jamieparkinson/nixie/hardware/nixie.pdf

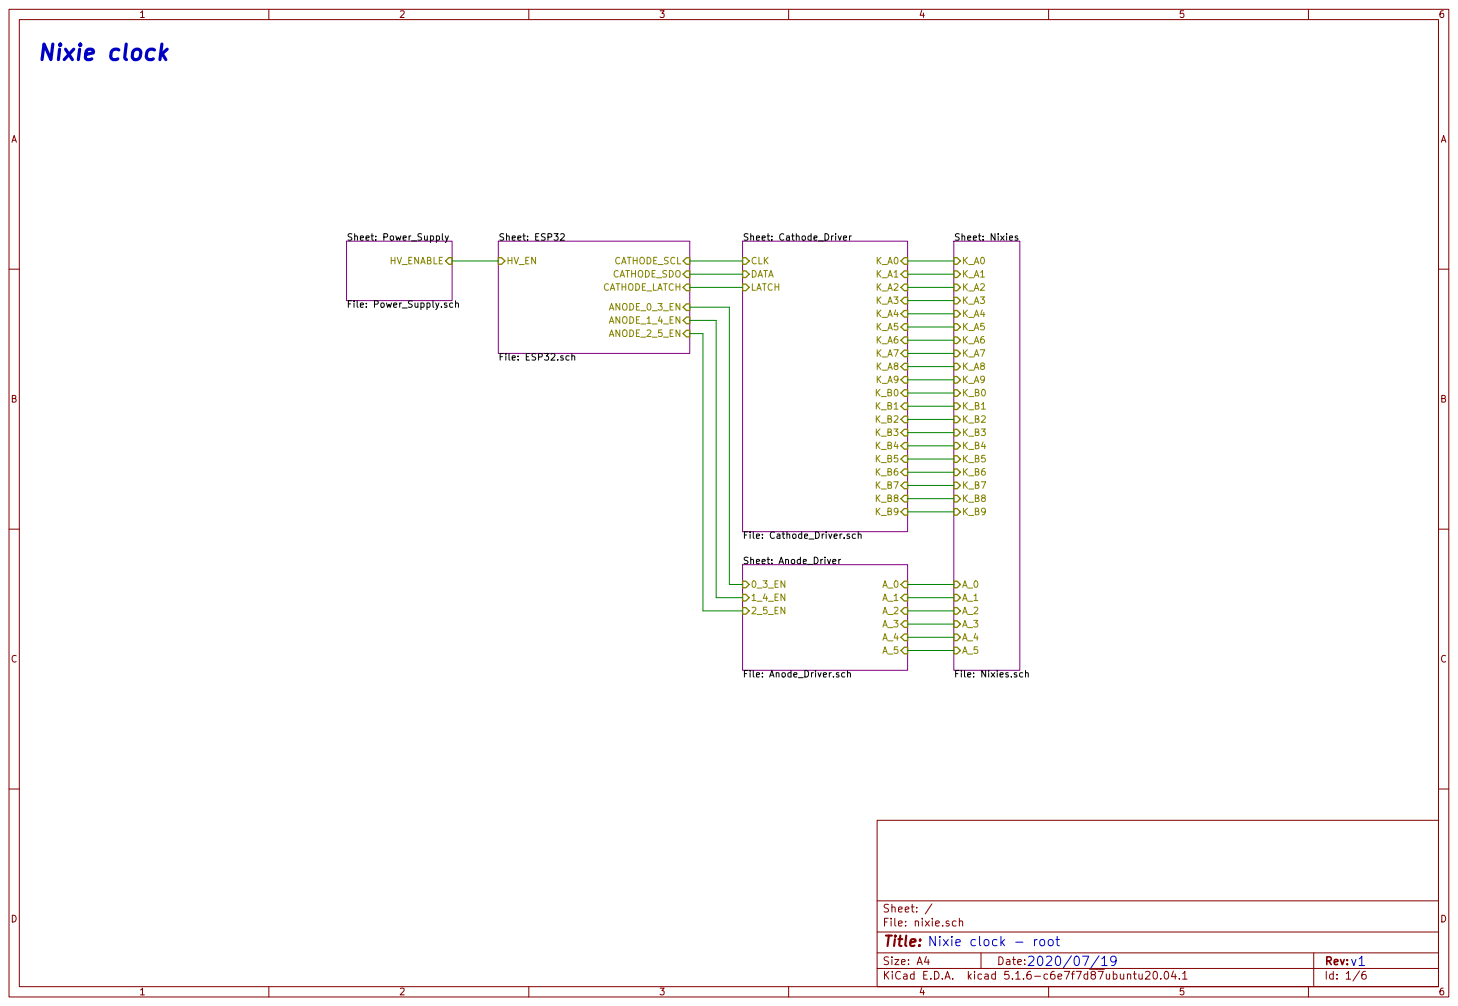
[picture p1: page 1]

Sheet: Nixies File: Nixies.sch A_0 A_1 A_2 A_3 A_4 A_5 K_B0 K_B1 K_B2 K_B3 K_B4 K_B5 K_B6 K_B7 K_B8 K_B9 K_A0 K_A1 K_A2 K_A3 K_A4 K_A5 K_A6 K_A7 K_A8 K_A9 Nixie clock - root

Id: 1/6 Title: File: nixie.sch Sheet: /

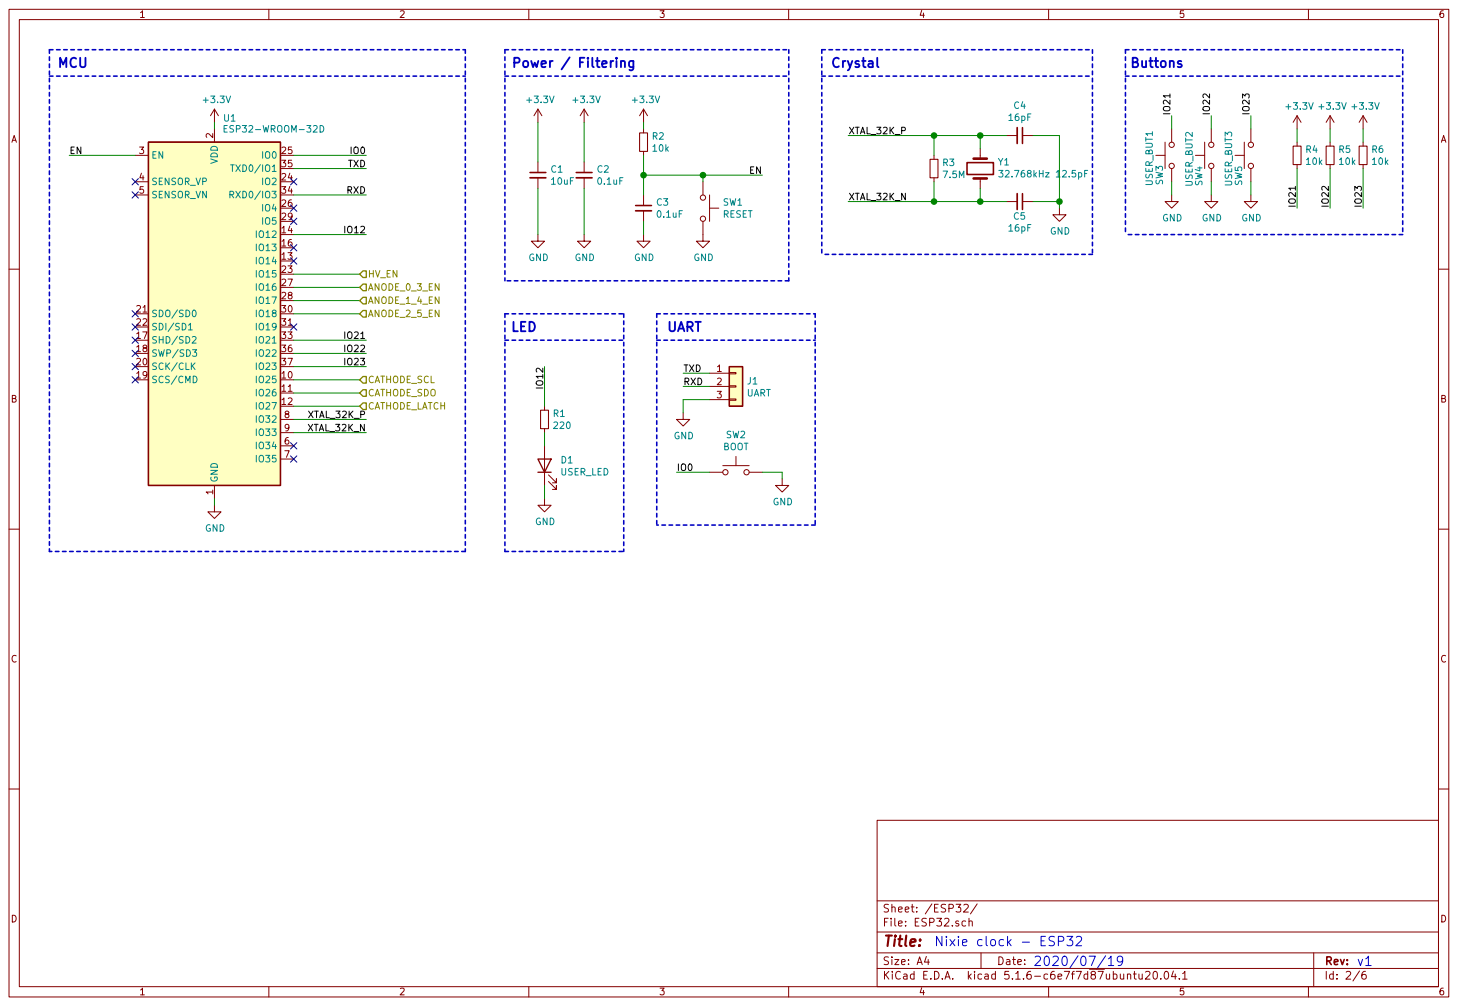
[picture p2: page 2]

2 SCK/CLK 20 SDO/SD0 21 SDI/SD1 22

Id: 2/6 Title: File: ESP32.sch Sheet: /ESP32/

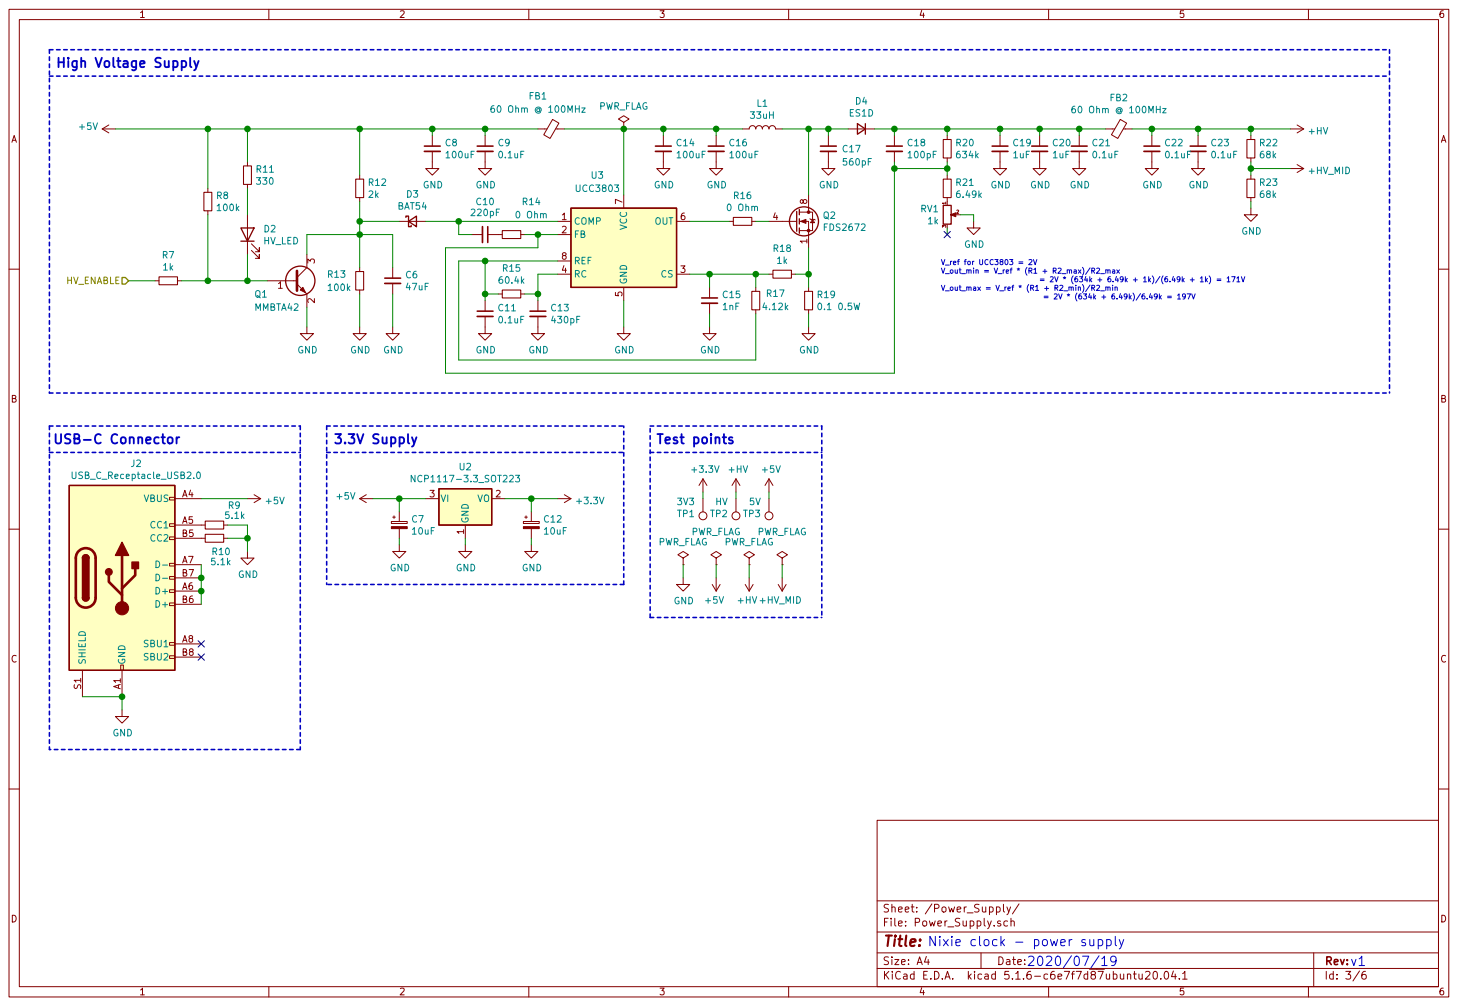
[picture p3: page 3]

File: Power_Supply.sch
Id: 3/6 Title:
Nixie clock - power supply

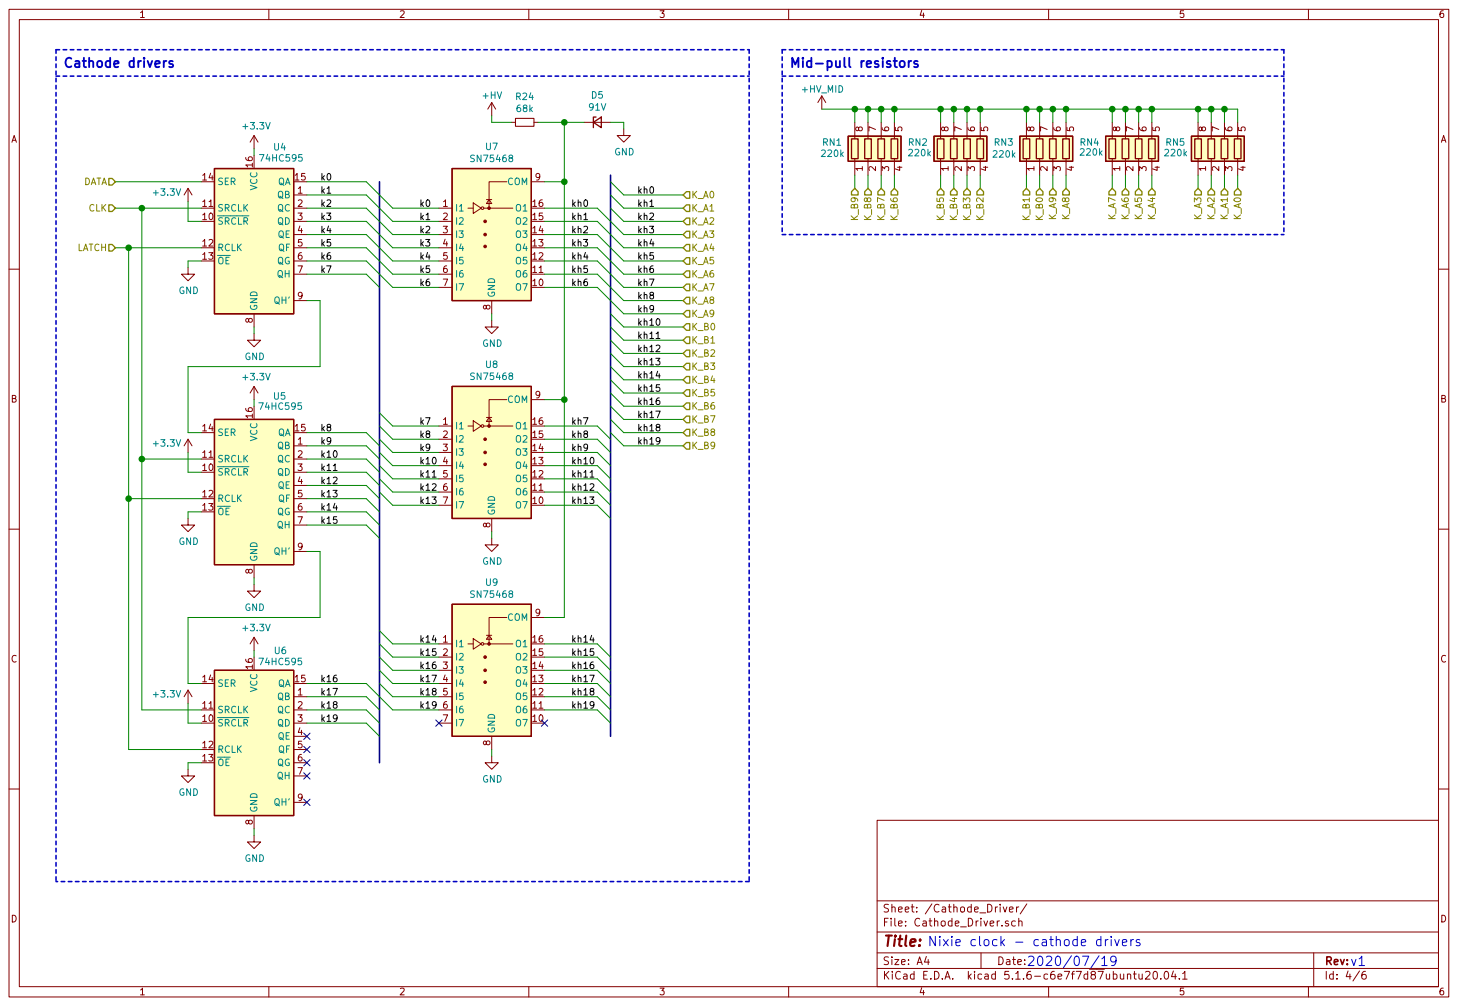
[picture p4: page 4]

Sheet: /Cathode_Driver/
File: Cathode_Driver.sch
Id: 4/6 Title:
Nixie clock - cathode drivers

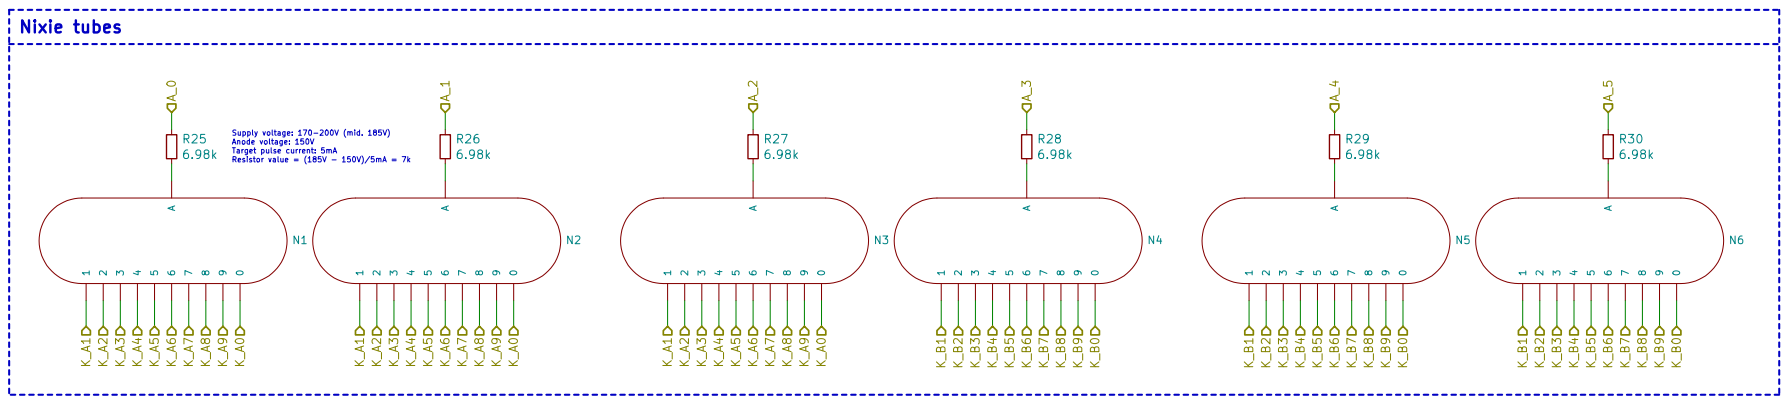
[picture p5: page 5]

Supply voltage: 170-200V (mid. 185V) Anode voltage: 150V

Target pulse current: 5mA Resistor value = (185V - 150V)/5mA = 7k

Id: 5/6 Title: File: Nixies.sch Sheet: /Nixies/
Nixie clock - nixie tubes

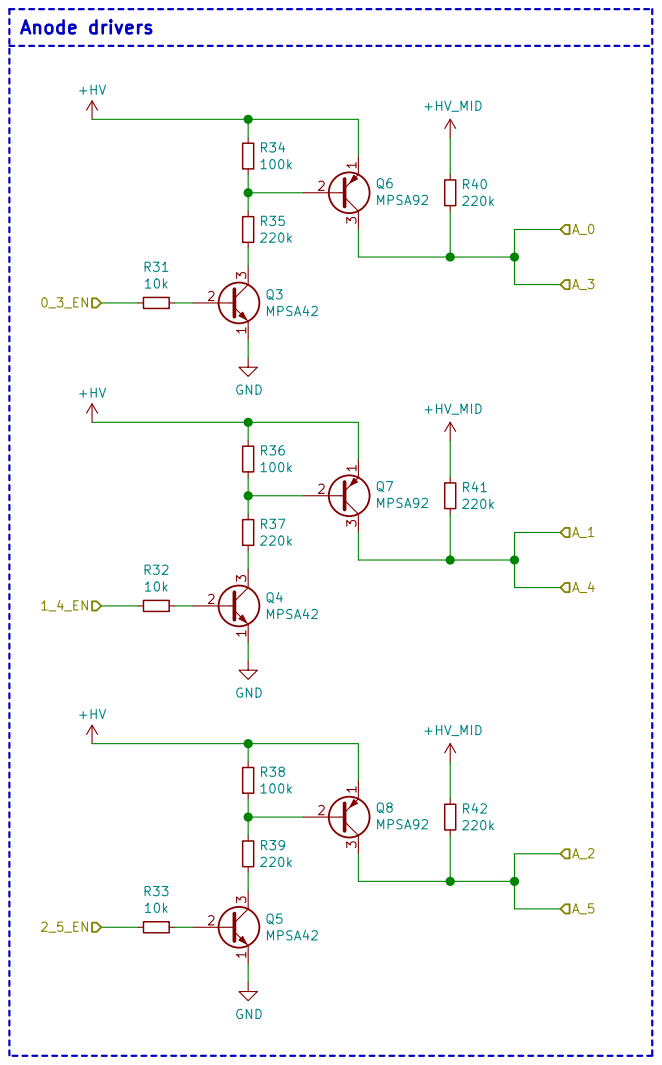
[picture p6: page 6]

File: Anode_Driver.sch
Id: 6/6 Title:
Nixie clock - anode driver
