jamieparkinson/nixie/hardware/nixie.kicad_pcb

## KiCad design hardware/nixie.kicad_pcb (2020-08-09)

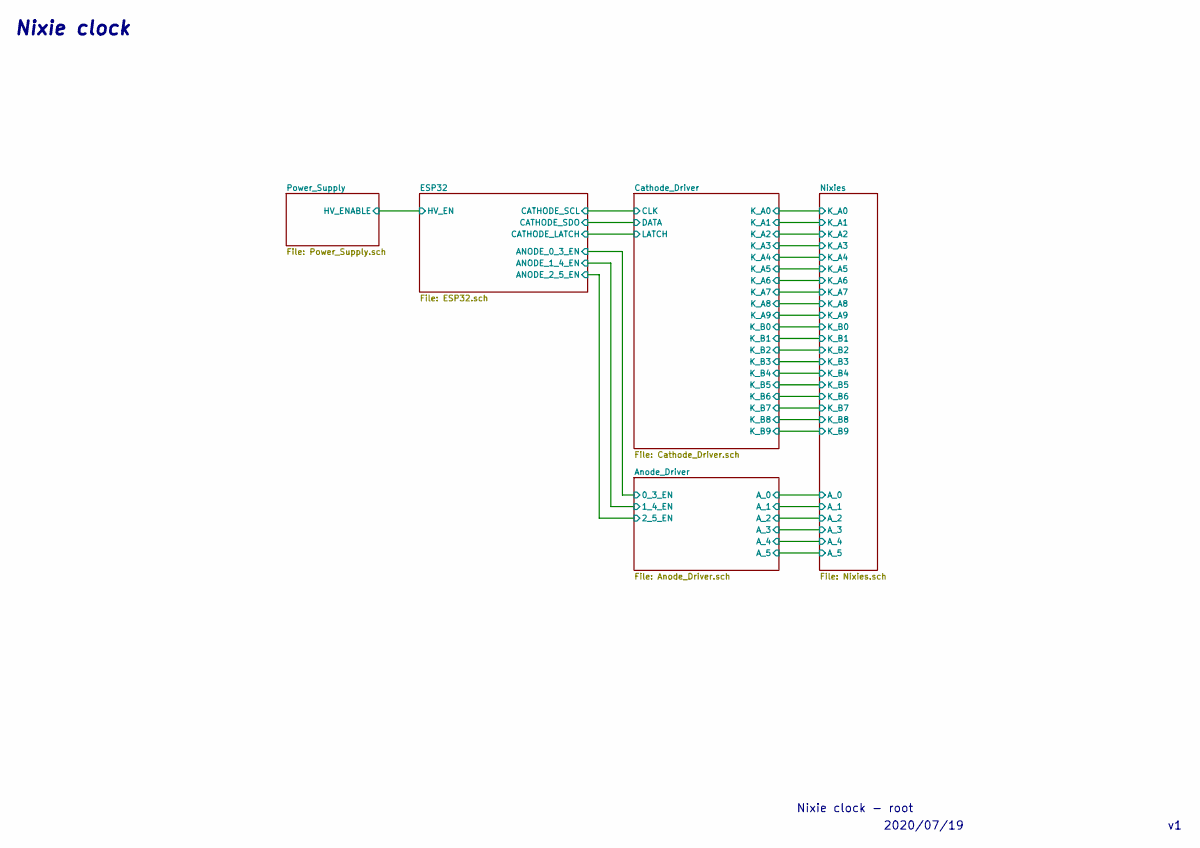
[picture p7: schematic nixie.sch]

Notes on the sheet:
Nixie clock - root
2020/07/19
Nixie clock

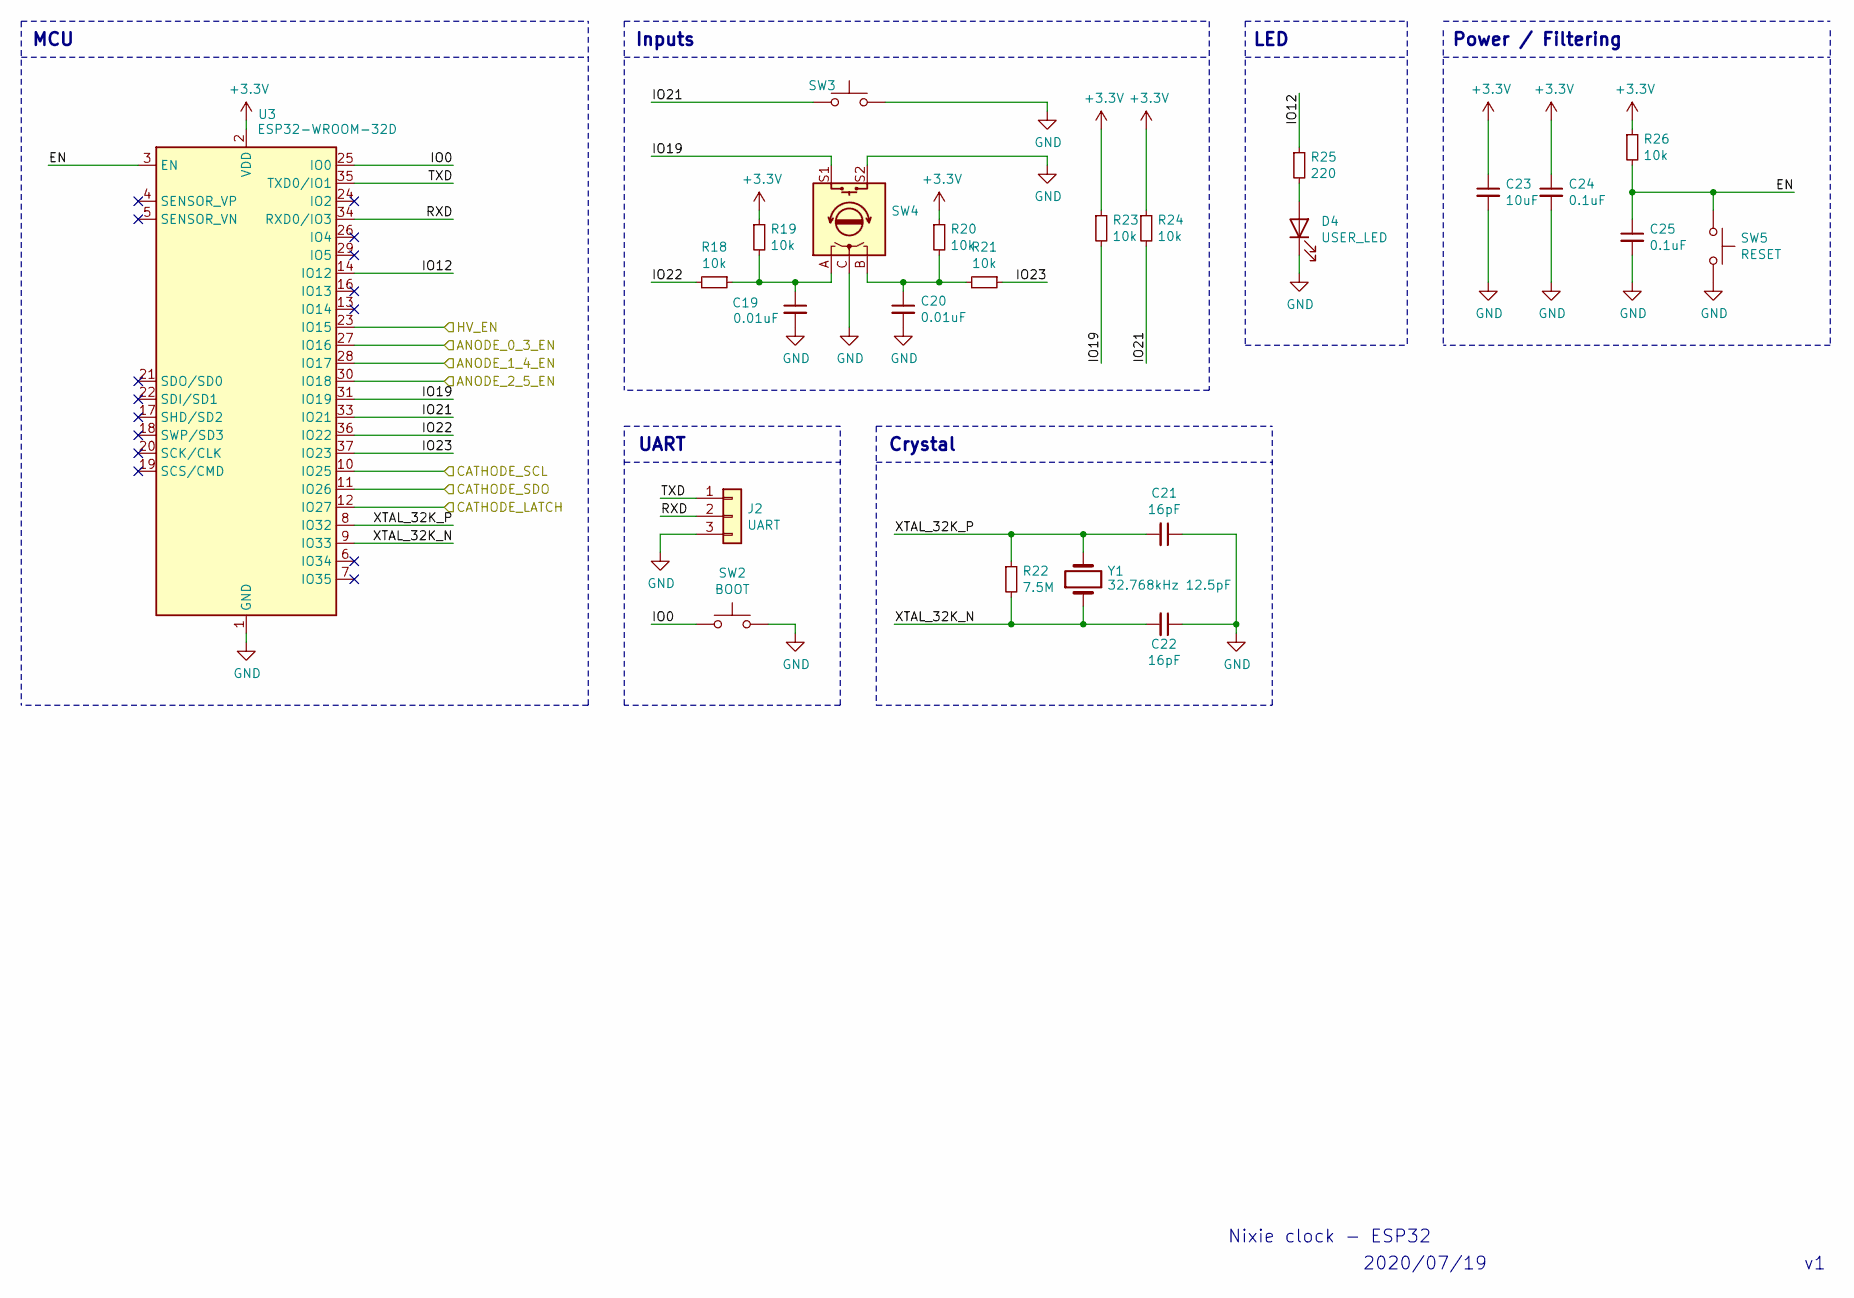
[picture p8: schematic ESP32.sch]

Parts:
C19, C20: 0.01uF; C_0603_1608Metric
C21, C22: 16pF; C_0603_1608Metric
C23: 10uF; C_0603_1608Metric
C24, C25: 0.1uF; C_0603_1608Metric
D4: USER_LED; LED_0805_2012Metric
J2: UART; PinHeader_1x03_P2.54mm_Horizontal
R18, R19, R20, R21, R23, R24, R26: 10k; R_0603_1608Metric
R22: 7.5M; R_0603_1608Metric
R25: 220; R_0603_1608Metric
SW2: BOOT; SW_Push_1P1T-SH_NO_CK_KMR2xxG
SW3: USER_BUT1; Switch_CK_D6
SW4: Rotary Encoder; RotaryEncoder_Alps_EC12E-Switch_Vertical_H20mm
SW5: RESET; SW_Push_1P1T-SH_NO_CK_KMR2xxG
U3: ESP32-WROOM-32D; ESP32-WROOM-32
Y1: 32.768kHz 12.5pF; XTAL_LFXTAL003000

Connections:
+3V3: C23.1, C24.1, R19.1, R20.1, R23.1, R24.1, R26.1, U3.2 (VDD); also elsewhere on the board
/Anode_Driver/0_3_EN: U3.27 (IO16); also elsewhere on the board
/Anode_Driver/1_4_EN: U3.28 (IO17); also elsewhere on the board
/Anode_Driver/2_5_EN: U3.30 (IO18); also elsewhere on the board
/ESP32/CATHODE_LATCH: U3.12 (IO27); also elsewhere on the board
/ESP32/CATHODE_SCL: U3.10 (IO25); also elsewhere on the board
/ESP32/CATHODE_SDO: U3.11 (IO26); also elsewhere on the board
/ESP32/EN: C25.1, R26.2, SW5.1, U3.3 (EN)
/ESP32/HV_EN: U3.23 (IO15); also elsewhere on the board
/ESP32/IO0: SW2.1, U3.25 (IO0)
/ESP32/IO12: R25.1, U3.14 (IO12)
/ESP32/IO19: R23.2, SW4.S1, U3.31 (IO19)
/ESP32/IO21: R24.2, SW3.1, U3.33 (IO21)
/ESP32/IO22: R18.2, U3.36 (IO22)
/ESP32/IO23: R21.1, U3.37 (IO23)
/ESP32/RXD: J2.2, U3.34 (RXD0/IO3)
/ESP32/TXD: J2.1, U3.35 (TXD0/IO1)
/ESP32/XTAL_32K_N: C22.2, R22.2, U3.9 (IO33), Y1.1
/ESP32/XTAL_32K_P: C21.2, R22.1, U3.8 (IO32), Y1.2
GND: C19.2, C20.2, C21.1, C22.1, C23.2, C24.2, C25.2, D4.1 (K), J2.3, SW2.2, SW3.2, SW4.C, SW4.S2, SW5.2, U3.1 (GND), U3.15 (GND), U3.38 (GND), U3.39 (GND); also elsewhere on the board
unnamed: C19.1, R18.1, R19.2, SW4.A
unnamed: C20.1, R20.2, R21.2, SW4.B
unnamed: D4.2 (A), R25.2

Notes on the sheet:
MCU
Power / Filtering
Crystal
LED
UART
Nixie clock - ESP32
2020/07/19
Inputs

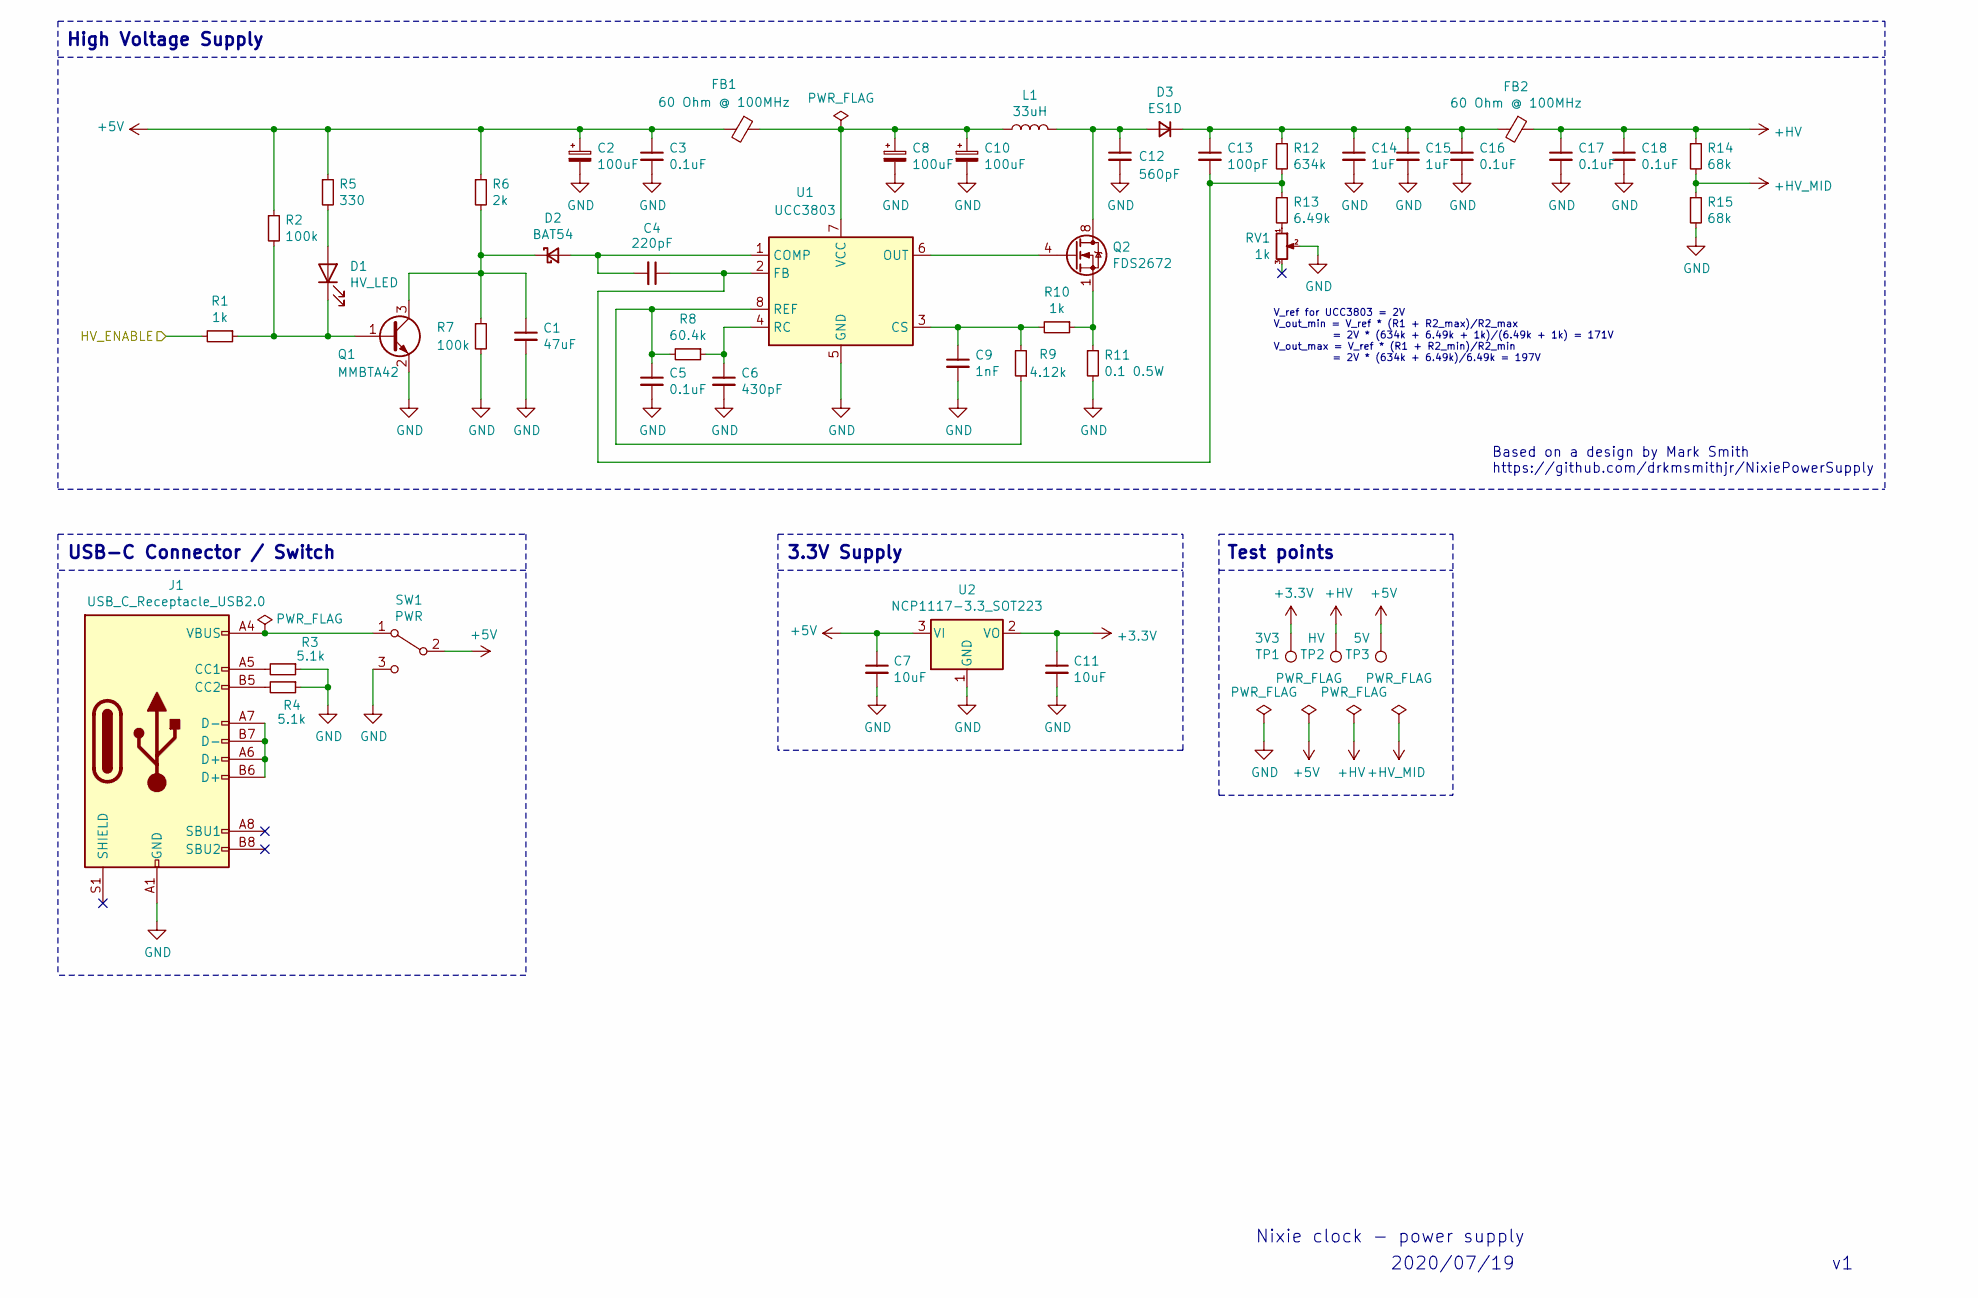
[picture p9: schematic Power_Supply.sch]

Parts:
C1: 47uF; C_0603_1608Metric
C2, C8, C10: 100uF; CP_Elec_5x5.4
C3, C5, C16, C17, C18: 0.1uF; C_0603_1608Metric
C4: 220pF; C_0603_1608Metric
C6: 430pF; C_0603_1608Metric
C7, C11: 10uF; C_0603_1608Metric
C9: 1nF; C_0603_1608Metric
C12: 560pF; C_0603_1608Metric
C13: 100pF; C_0603_1608Metric
C14, C15: 1uF; C_0603_1608Metric
D1: HV_LED; LED_0805_2012Metric
D2: BAT54; D_SOT-23_ANK
D3: ES1D; D_SMA_Handsoldering
FB1, FB2: 60 Ohm @ 100MHz; L_0603_1608Metric
J1: USB_C_Receptacle_USB2.0; WURTH_632723100011
L1: 33uH; L_12x12mm_H8mm
Q1: MMBTA42; SOT-23
Q2: FDS2672; SOIC-8_3.9x4.9mm_P1.27mm
R1, R10: 1k; R_0603_1608Metric
R2, R7: 100k; R_0603_1608Metric
R3, R4: 5.1k; R_0603_1608Metric
R5: 330; R_0603_1608Metric
R6: 2k; R_0603_1608Metric
R8: 60.4k; R_0603_1608Metric
R9: 4.12k; R_0603_1608Metric
R11: 0.1 0.5W; R_1210_3225Metric
R12: 634k; R_0603_1608Metric
R13: 6.49k; R_0603_1608Metric
R14, R15: 68k; R_0603_1608Metric
RV1: 1k; Potentiometer_Bourns_3314G_Vertical
SW1: PWR; SW_SPDT_CK-JS102011SAQN
TP1: 3V3; TestPoint_Pad_D2.0mm
TP2: HV; TestPoint_Pad_D2.0mm
TP3: 5V; TestPoint_Pad_D2.0mm
U1: UCC3803; SOIC-8_3.9x4.9mm_P1.27mm
U2: NCP1117-3.3_SOT223; SOT-223-3_TabPin2

Connections:
+3V3: C11.1, TP1.1, U2.2 (VO); also elsewhere on the board
+5V: C2.1, C3.1, C7.1, FB1.2, R2.1, R5.1, R6.1, SW1.2 (B), TP3.1, U2.3 (VI)
+HV: C17.1, C18.1, FB2.1, R14.1, TP2.1; also elsewhere on the board
+HV_MID: R14.2, R15.1; also elsewhere on the board
/ESP32/HV_EN: R1.2; also elsewhere on the board
GND: C1.2, C2.2, C3.2, C5.2, C6.2, C7.2, C8.2, C9.2, C10.2, C11.2, C12.2, C14.2, C15.2, C16.2, C17.2, C18.2, J1.A1 (GND), J1.A12 (GND), J1.B1 (GND), J1.B12 (GND), Q1.2 (E), R3.1, R4.1, R7.2, R11.2, R15.2, RV1.2, SW1.3 (C), U1.5 (GND), U2.1 (GND); also elsewhere on the board
unnamed: C1.1, D2.1 (K), Q1.3 (C), R6.2, R7.1
unnamed: C4.2, D2.2 (A), U1.1 (COMP)
unnamed: C5.1, R8.2, R9.1, U1.8 (REF)
unnamed: C6.1, R8.1, U1.4 (RC)
unnamed: C9.1, R9.2, R10.2, U1.3 (CS)
unnamed: C8.1, C10.1, FB1.1, L1.1, U1.7 (VCC)
unnamed: C12.1, D3.2 (A), L1.2, Q2.5 (D), Q2.6 (D), Q2.7 (D), Q2.8 (D)
unnamed: C13.1, C14.1, C15.1, C16.1, D3.1 (K), FB2.2, R12.1
unnamed: C4.1, C13.2, R12.2, R13.1, U1.2 (FB)
unnamed: D1.1 (K), Q1.1 (B), R1.1, R2.2
unnamed: D1.2 (A), R5.2
unnamed: J1.A4 (VBUS), J1.A9 (VBUS), J1.B4 (VBUS), J1.B9 (VBUS), SW1.1 (A)
unnamed: J1.A5 (CC1), R3.2
unnamed: J1.A6 (D+), J1.A7 (D-), J1.B6 (D+), J1.B7 (D-)
unnamed: J1.B5 (CC2), R4.2
unnamed: Q2.1 (S), Q2.2 (S), Q2.3 (S), R10.1, R11.1
unnamed: Q2.4 (G), U1.6 (OUT)
unnamed: R13.2, RV1.1

Notes on the sheet:
USB-C Connector / Switch
3.3V Supply
Test points
High Voltage Supply
Nixie clock - power supply
2020/07/19
V_ref for UCC3803 = 2V V_out_min = V_ref * (R1 + R2_max)/R2_max = 2V * (634k + 6.49k + 1k)/(6.49k + 1k) = 171V V_out_max = V_ref * (R1 + R2_min)/R2_min = 2V * (634k + 6.49k)/6.49k = 197V
Based on a design by Mark Smith https://github.com/drkmsmithjr/NixiePowerSupply

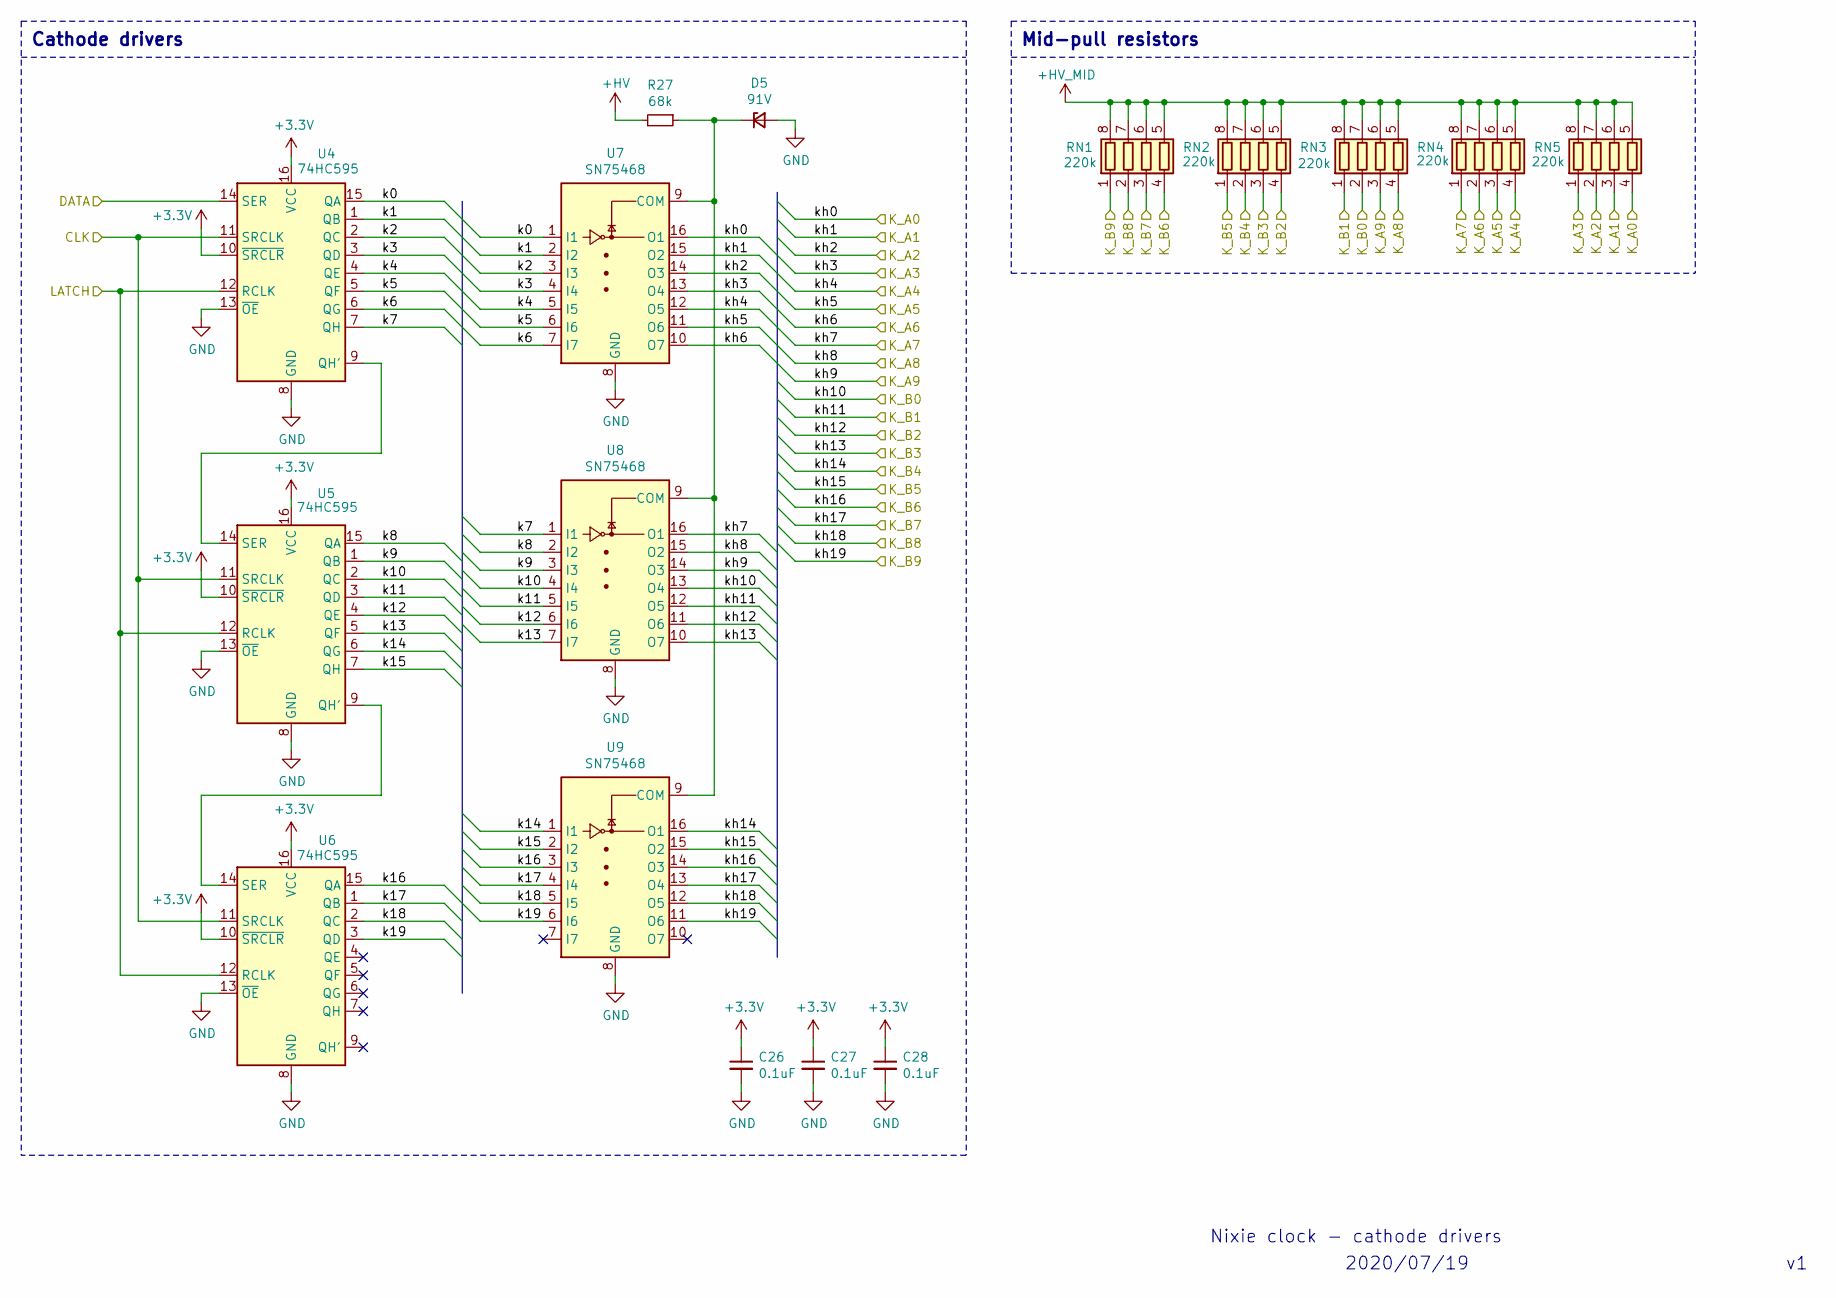
[picture p10: schematic Cathode_Driver.sch]

Parts:
C26, C27, C28: 0.1uF; C_0603_1608Metric
D5: 91V; D_SOD-123
R27: 68k; R_0603_1608Metric
RN1, RN2, RN3, RN4, RN5: 220k; R_Array_Convex_4x1206
U4, U5, U6: 74HC595; SOIC-16_3.9x9.9mm_P1.27mm
U7, U8, U9: SN75468; SOIC-16_3.9x9.9mm_P1.27mm

Connections:
+3V3: C26.1, C27.1, C28.1, U4.10 (~SRCLR), U4.16 (VCC), U5.10 (~SRCLR), U5.16 (VCC), U6.10 (~SRCLR), U6.16 (VCC); also elsewhere on the board
+HV: R27.2; also elsewhere on the board
+HV_MID: RN1.5 (R4.2), RN1.6 (R3.2), RN1.7 (R2.2), RN1.8 (R1.2), RN2.5 (R4.2), RN2.6 (R3.2), RN2.7 (R2.2), RN2.8 (R1.2), RN3.5 (R4.2), RN3.6 (R3.2), RN3.7 (R2.2), RN3.8 (R1.2), RN4.5 (R4.2), RN4.6 (R3.2), RN4.7 (R2.2), RN4.8 (R1.2), RN5.5 (R4.2), RN5.6 (R3.2), RN5.7 (R2.2), RN5.8 (R1.2); also elsewhere on the board
/Cathode_Driver/K_A0: RN5.4 (R4.1), U7.16 (O1); also elsewhere on the board
/Cathode_Driver/K_A1: RN5.3 (R3.1), U7.15 (O2); also elsewhere on the board
/Cathode_Driver/K_A2: RN5.2 (R2.1), U7.14 (O3); also elsewhere on the board
/Cathode_Driver/K_A3: RN5.1 (R1.1), U7.13 (O4); also elsewhere on the board
/Cathode_Driver/K_A4: RN4.4 (R4.1), U7.12 (O5); also elsewhere on the board
/Cathode_Driver/K_A5: RN4.3 (R3.1), U7.11 (O6); also elsewhere on the board
/Cathode_Driver/K_A6: RN4.2 (R2.1), U7.10 (O7); also elsewhere on the board
/Cathode_Driver/K_A7: RN4.1 (R1.1), U8.16 (O1); also elsewhere on the board
/Cathode_Driver/K_A8: RN3.4 (R4.1), U8.15 (O2); also elsewhere on the board
/Cathode_Driver/K_A9: RN3.3 (R3.1), U8.14 (O3); also elsewhere on the board
/Cathode_Driver/K_B0: RN3.2 (R2.1), U8.13 (O4); also elsewhere on the board
/Cathode_Driver/K_B1: RN3.1 (R1.1), U8.12 (O5); also elsewhere on the board
/Cathode_Driver/K_B2: RN2.4 (R4.1), U8.11 (O6); also elsewhere on the board
/Cathode_Driver/K_B3: RN2.3 (R3.1), U8.10 (O7); also elsewhere on the board
/Cathode_Driver/K_B4: RN2.2 (R2.1), U9.16 (O1); also elsewhere on the board
/Cathode_Driver/K_B5: RN2.1 (R1.1), U9.15 (O2); also elsewhere on the board
/Cathode_Driver/K_B6: RN1.4 (R4.1), U9.14 (O3); also elsewhere on the board
/Cathode_Driver/K_B7: RN1.3 (R3.1), U9.13 (O4); also elsewhere on the board
/Cathode_Driver/K_B8: RN1.2 (R2.1), U9.12 (O5); also elsewhere on the board
/Cathode_Driver/K_B9: RN1.1 (R1.1), U9.11 (O6); also elsewhere on the board
/Cathode_Driver/k0: U4.15 (QA), U7.1 (I1)
/Cathode_Driver/k1: U4.1 (QB), U7.2 (I2)
/Cathode_Driver/k2: U4.2 (QC), U7.3 (I3)
/Cathode_Driver/k3: U4.3 (QD), U7.4 (I4)
/Cathode_Driver/k4: U4.4 (QE), U7.5 (I5)
/Cathode_Driver/k5: U4.5 (QF), U7.6 (I6)
/Cathode_Driver/k6: U4.6 (QG), U7.7 (I7)
/Cathode_Driver/k7: U4.7 (QH), U8.1 (I1)
/Cathode_Driver/k8: U5.15 (QA), U8.2 (I2)
/Cathode_Driver/k9: U5.1 (QB), U8.3 (I3)
/Cathode_Driver/k10: U5.2 (QC), U8.4 (I4)
/Cathode_Driver/k11: U5.3 (QD), U8.5 (I5)
/Cathode_Driver/k12: U5.4 (QE), U8.6 (I6)
/Cathode_Driver/k13: U5.5 (QF), U8.7 (I7)
/Cathode_Driver/k14: U5.6 (QG), U9.1 (I1)
/Cathode_Driver/k15: U5.7 (QH), U9.2 (I2)
/Cathode_Driver/k16: U6.15 (QA), U9.3 (I3)
/Cathode_Driver/k17: U6.1 (QB), U9.4 (I4)
/Cathode_Driver/k18: U6.2 (QC), U9.5 (I5)
/Cathode_Driver/k19: U6.3 (QD), U9.6 (I6)
/ESP32/CATHODE_LATCH: U4.12 (RCLK), U5.12 (RCLK), U6.12 (RCLK); also elsewhere on the board
/ESP32/CATHODE_SCL: U4.11 (SRCLK), U5.11 (SRCLK), U6.11 (SRCLK); also elsewhere on the board
/ESP32/CATHODE_SDO: U4.14 (SER); also elsewhere on the board
GND: C26.2, C27.2, C28.2, D5.2 (A), U4.8 (GND), U4.13 (~OE), U5.8 (GND), U5.13 (~OE), U6.8 (GND), U6.13 (~OE), U7.8 (GND), U8.8 (GND), U9.8 (GND); also elsewhere on the board
unnamed: D5.1 (K), R27.1, U7.9 (COM), U8.9 (COM), U9.9 (COM)
unnamed: U4.9 (QH'), U5.14 (SER)
unnamed: U5.9 (QH'), U6.14 (SER)

Notes on the sheet:
Cathode drivers
Mid-pull resistors
Nixie clock - cathode drivers
2020/07/19

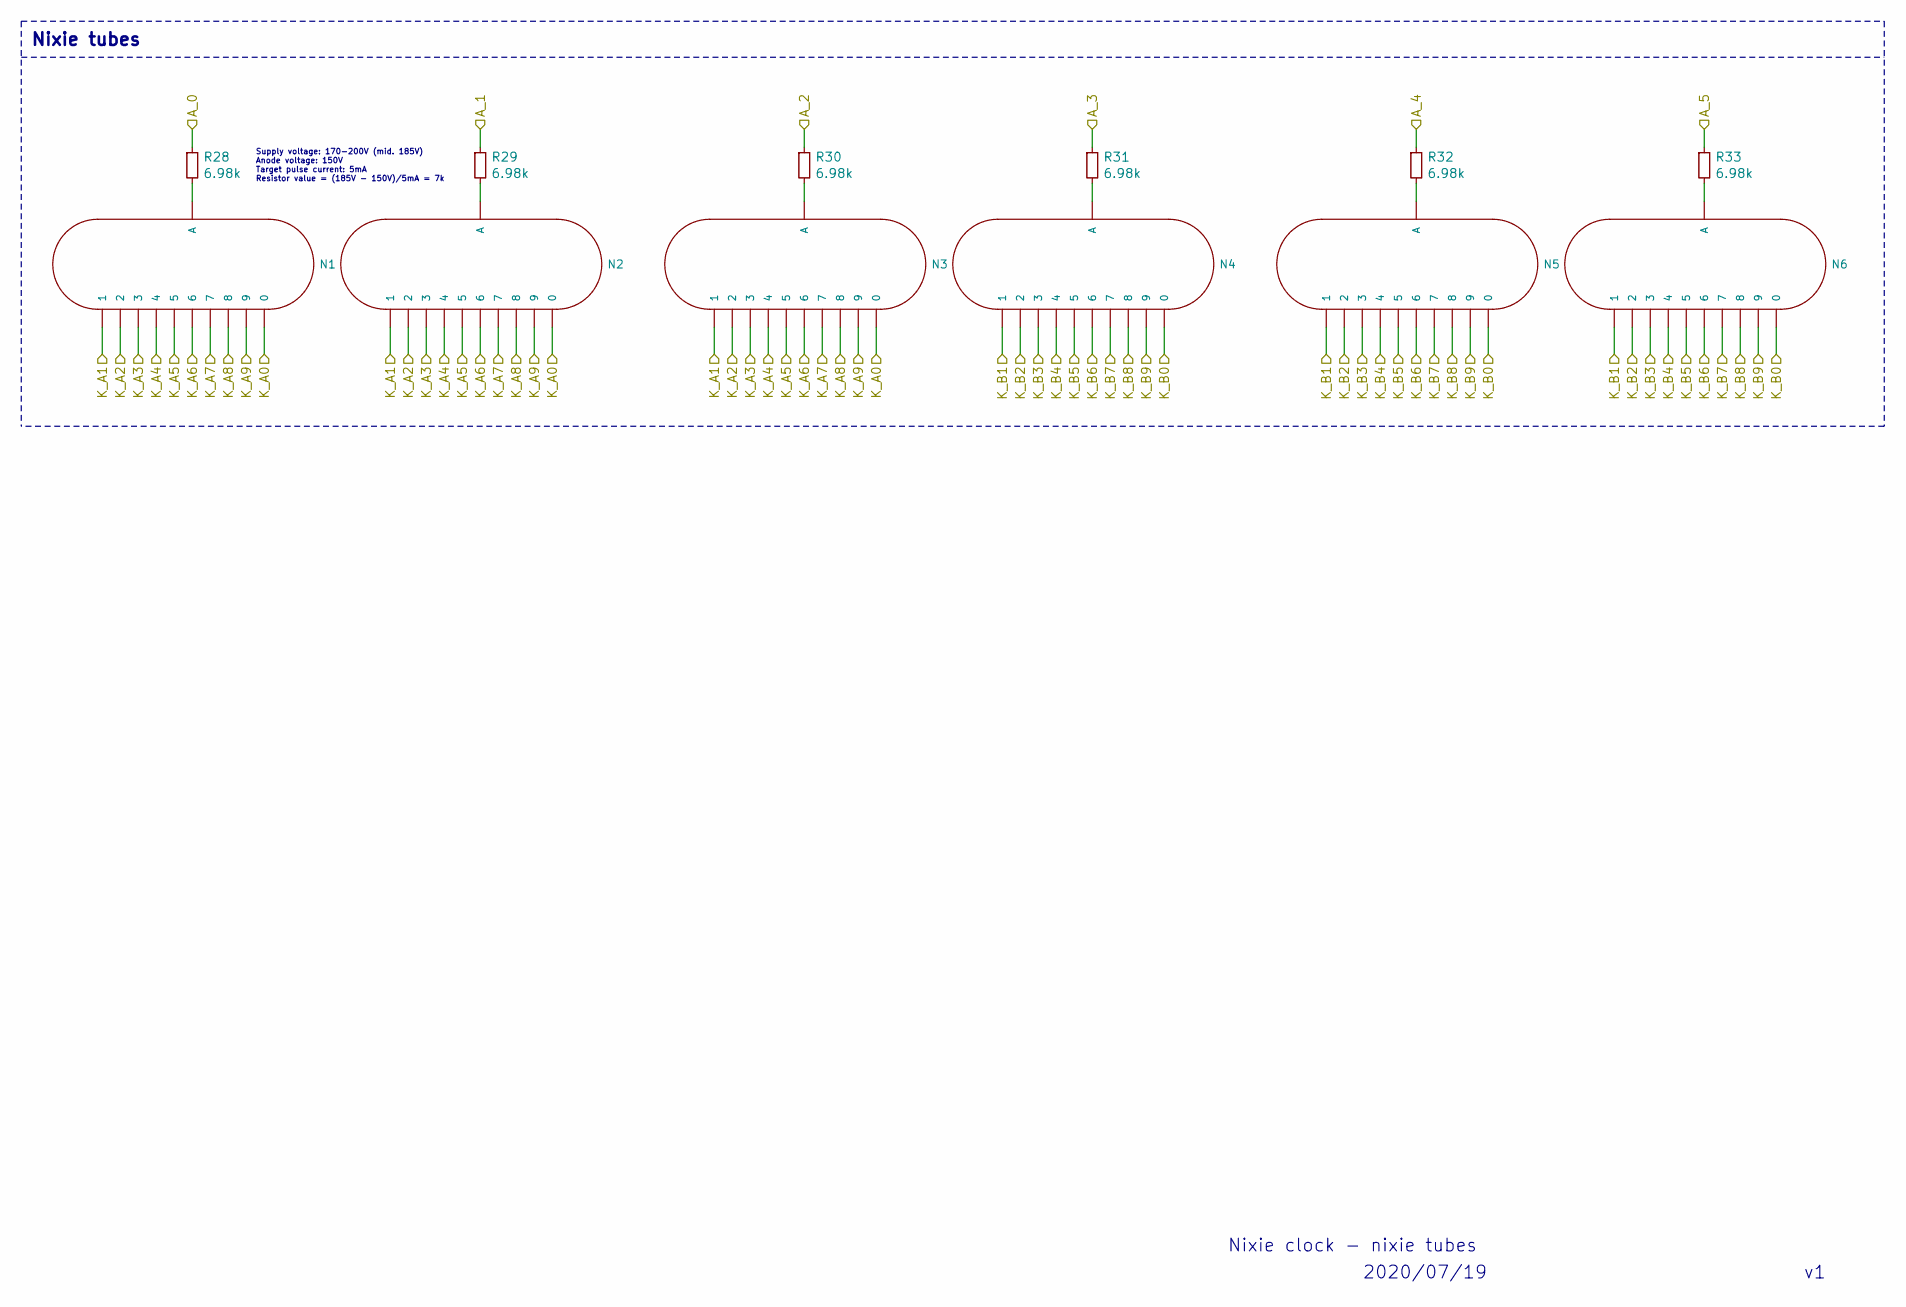
[picture p11: schematic Nixies.sch]

Parts:
N1, N2, N3, N4, N5, N6: IN-8; nixies-us-IN-8
R28, R29, R30, R31, R32, R33: 6.98k; R_0603_1608Metric

Connections:
/Anode_Driver/A_0: R28.1, R31.1; also elsewhere on the board
/Anode_Driver/A_1: R29.1, R32.1; also elsewhere on the board
/Anode_Driver/A_2: R30.1, R33.1; also elsewhere on the board
/Cathode_Driver/K_A0: N1.0, N2.0, N3.0; also elsewhere on the board
/Cathode_Driver/K_A1: N1.1, N2.1, N3.1; also elsewhere on the board
/Cathode_Driver/K_A2: N1.2, N2.2, N3.2; also elsewhere on the board
/Cathode_Driver/K_A3: N1.3, N2.3, N3.3; also elsewhere on the board
/Cathode_Driver/K_A4: N1.4, N2.4, N3.4; also elsewhere on the board
/Cathode_Driver/K_A5: N1.5, N2.5, N3.5; also elsewhere on the board
/Cathode_Driver/K_A6: N1.6, N2.6, N3.6; also elsewhere on the board
/Cathode_Driver/K_A7: N1.7, N2.7, N3.7; also elsewhere on the board
/Cathode_Driver/K_A8: N1.8, N2.8, N3.8; also elsewhere on the board
/Cathode_Driver/K_A9: N1.9, N2.9, N3.9; also elsewhere on the board
/Cathode_Driver/K_B0: N4.0, N5.0, N6.0; also elsewhere on the board
/Cathode_Driver/K_B1: N4.1, N5.1, N6.1; also elsewhere on the board
/Cathode_Driver/K_B2: N4.2, N5.2, N6.2; also elsewhere on the board
/Cathode_Driver/K_B3: N4.3, N5.3, N6.3; also elsewhere on the board
/Cathode_Driver/K_B4: N4.4, N5.4, N6.4; also elsewhere on the board
/Cathode_Driver/K_B5: N4.5, N5.5, N6.5; also elsewhere on the board
/Cathode_Driver/K_B6: N4.6, N5.6, N6.6; also elsewhere on the board
/Cathode_Driver/K_B7: N4.7, N5.7, N6.7; also elsewhere on the board
/Cathode_Driver/K_B8: N4.8, N5.8, N6.8; also elsewhere on the board
/Cathode_Driver/K_B9: N4.9, N5.9, N6.9; also elsewhere on the board
unnamed: N1.A, R28.2
unnamed: N2.A, R29.2
unnamed: N3.A, R30.2
unnamed: N4.A, R31.2
unnamed: N5.A, R32.2
unnamed: N6.A, R33.2

Notes on the sheet:
Nixie tubes
Nixie clock - nixie tubes
2020/07/19
Supply voltage: 170-200V (mid. 185V) Anode voltage: 150V Target pulse current: 5mA Resistor value = (185V - 150V)/5mA = 7k

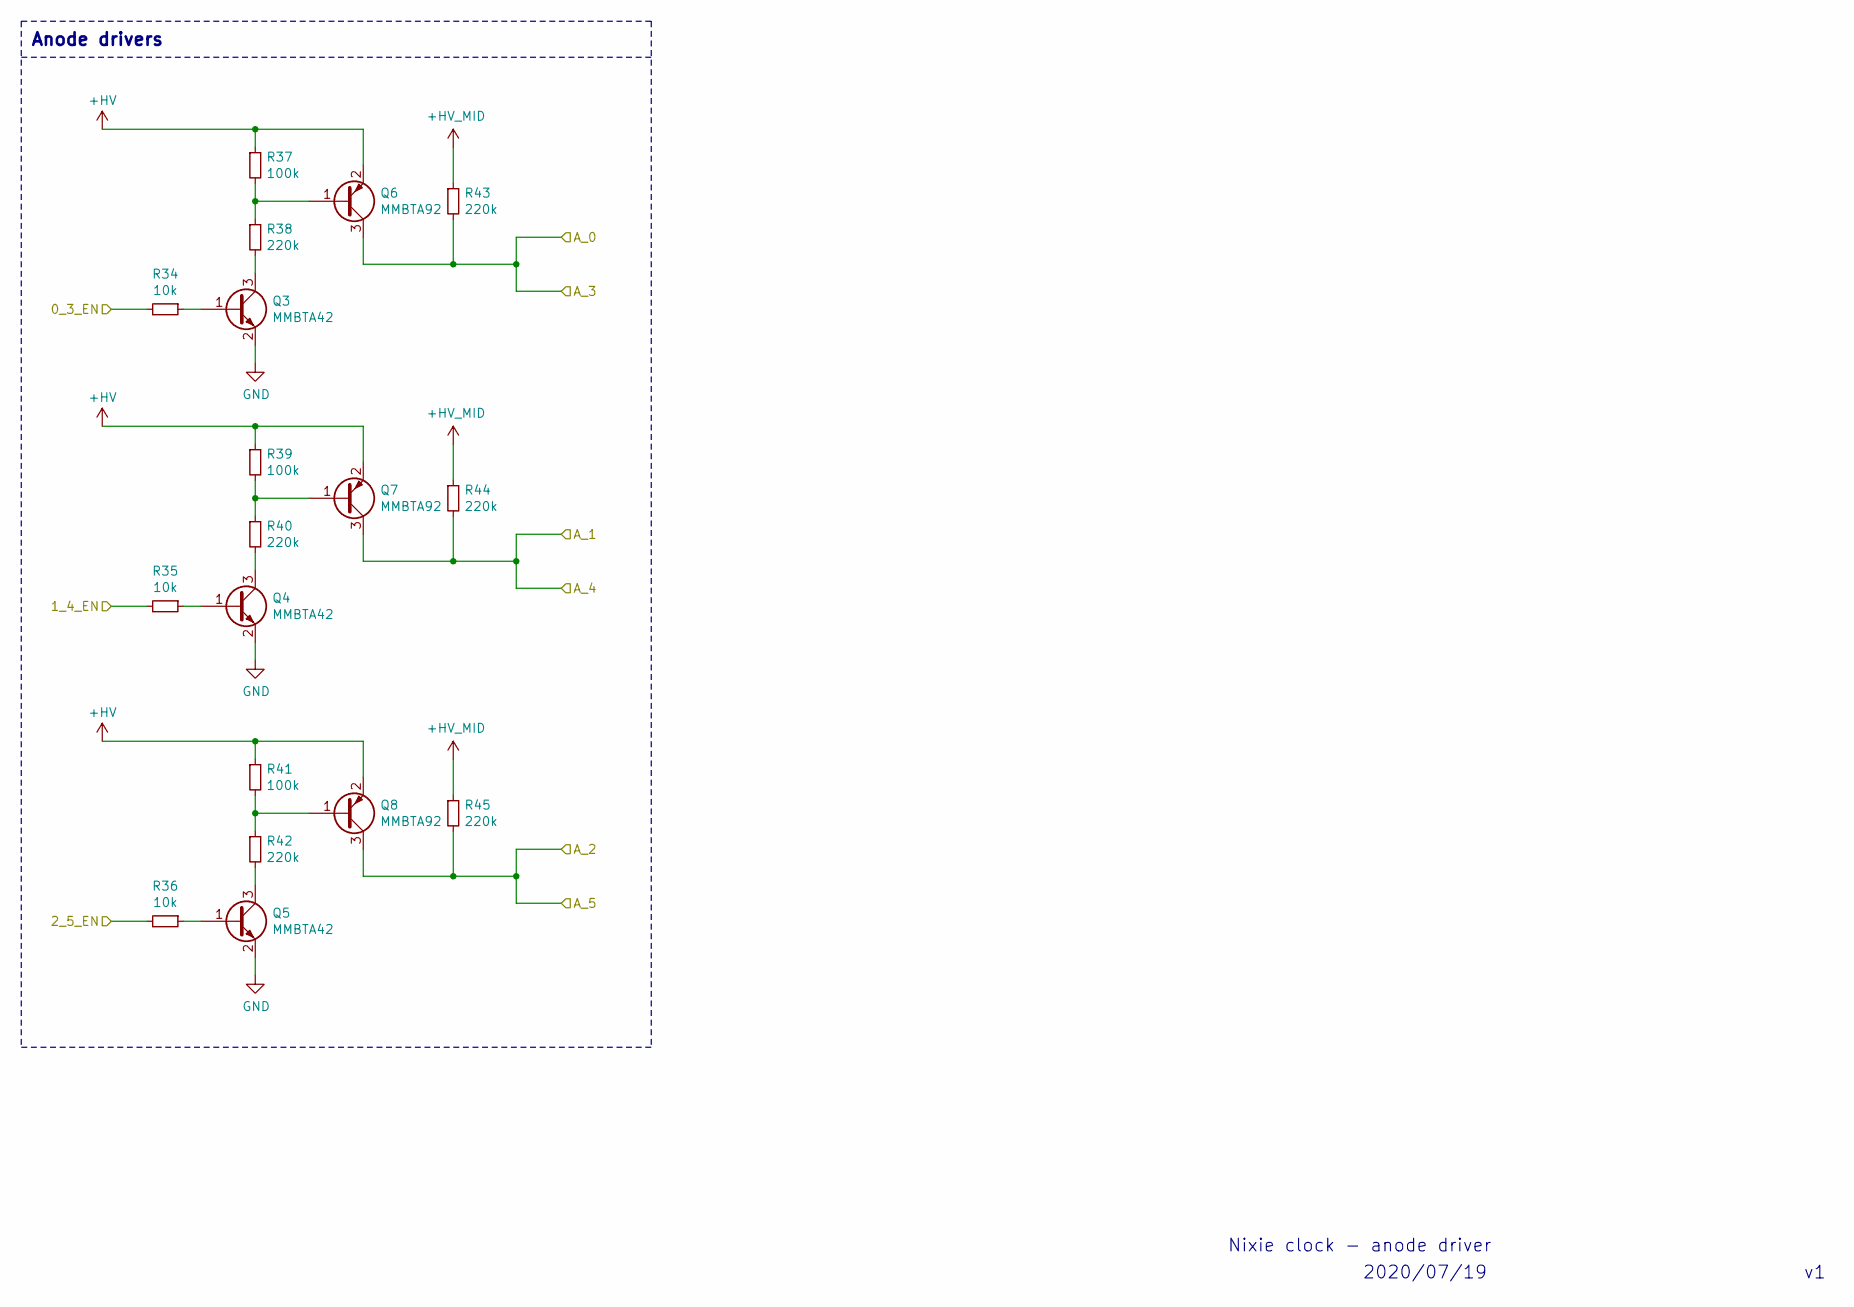
[picture p12: schematic Anode_Driver.sch]

Parts:
Q3, Q4, Q5: MMBTA42; SOT-23
Q6, Q7, Q8: MMBTA92; SOT-23
R34, R35, R36: 10k; R_0603_1608Metric
R37, R39, R41: 100k; R_0603_1608Metric
R38, R40, R42, R43, R44, R45: 220k; R_0603_1608Metric

Connections:
+HV: Q6.2 (E), Q7.2 (E), Q8.2 (E), R37.1, R39.1, R41.1; also elsewhere on the board
+HV_MID: R43.1, R44.1, R45.1; also elsewhere on the board
/Anode_Driver/0_3_EN: R34.2; also elsewhere on the board
/Anode_Driver/1_4_EN: R35.2; also elsewhere on the board
/Anode_Driver/2_5_EN: R36.2; also elsewhere on the board
/Anode_Driver/A_0: Q6.3 (C), R43.2; also elsewhere on the board
/Anode_Driver/A_1: Q7.3 (C), R44.2; also elsewhere on the board
/Anode_Driver/A_2: Q8.3 (C), R45.2; also elsewhere on the board
GND: Q3.2 (E), Q4.2 (E), Q5.2 (E); also elsewhere on the board
unnamed: Q3.1 (B), R34.1
unnamed: Q3.3 (C), R38.2
unnamed: Q4.1 (B), R35.1
unnamed: Q4.3 (C), R40.2
unnamed: Q5.1 (B), R36.1
unnamed: Q5.3 (C), R42.2
unnamed: Q6.1 (B), R37.2, R38.1
unnamed: Q7.1 (B), R39.2, R40.1
unnamed: Q8.1 (B), R41.2, R42.1

Notes on the sheet:
Anode drivers
Nixie clock - anode driver
2020/07/19

Board: 2 copper layers, 119 parts (0 on the bottom side), 105 nets, no tracks yet.
