jamieparkinson/nixie/(commit log)

2020-07-25 Add v1 of schematic
    [Anode_Driver.sch, Cathode_Driver.sch, ESP32.sch, Nixies.sch, PowerSupply.sch, Power_Supply.sch, nixie.kicad_pcb, nixie.sch]
2020-08-05 Replace 2 switches with a rotary encoder, other tweaks and annotations
    [Anode_Driver.sch, Cathode_Driver.sch, ESP32.sch, Nixies.sch, Power_Supply.sch]
2020-08-09 Create footprints and netlist
    [Anode_Driver.sch, Cathode_Driver.sch, ESP32.sch, Nixies.sch, Power_Supply.sch, nixie.kicad_pcb]
